DanielLevinBusiness/FinalProject/פרוייקט גמר/WhatsApp Image 2019-11-20 at 18.02.19.jpeg

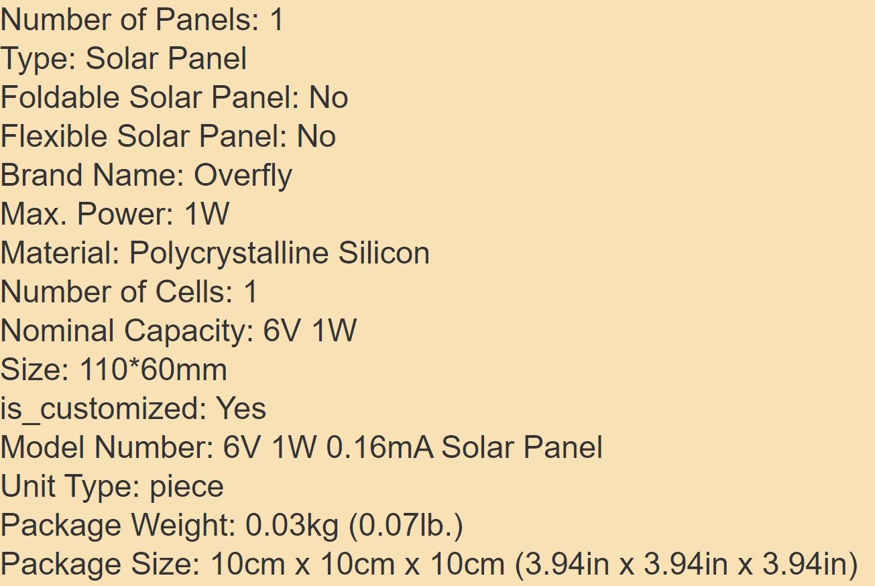
פרוייקט גמר/WhatsApp Image 2019-11-20 at 18.02.19.jpeg
